andersm/usbcart/usbcart-mfg/readme.txt

Manufacturing documents for USB Flash Cartridge for the Sega Saturn
<http://www.iki.fi/Anders.Montonen/sega/usbcart/>

Released under the terms of the Creative Commons Attribution-ShareAlike 3.0 Unported (CC BY-SA 3.0)
<http://creativecommons.org/licenses/by-sa/3.0/>

The cartridge should be made using 1.6mm thick PCB material. The bottom silkscreen layer contains
the board outline.

The BOM lists example manufacturer part numbers for the logic ICs, but equivalent parts from other
manufacturers can be substituted.
