andersm/usbcart/(threads)

Thread 2 (2017-06-27):

Build and flash

aovrn, 2017-06-27:
Hi!
I tried to build pcb and flash it.
I built romimage.bin with this tool: gnush_v10.03_elf-1-1.i386.rpm (it's right compiler?)
Linker outputs this warning:
 .../4.5-GNUSH_v10.03/../../../../sh-elf/bin/ld: warning: dot moved backwards before `.rodata.align2'
Is it problem or I can ignore it?

And second question how can I flash firmware to chip? Any information about it would be useful for me. I got fail with swap trick, so I need flash firmware before build cart.

Thank you very much!

andersm, 2017-06-27:
It's probably not a problem, but can't say for sure. The toolchains I'm using don't produce any warnings.

If you can't get code running on the Saturn you'll have to use an eprommer to program the chips before soldering them.

aovrn, 2017-06-28:
Thank you for answer!
I need to flash raw romimage.bin or it needs some preparation?

andersm, 2017-06-28:
The compiled image is ready for flashing.

aovsu, 2017-06-30:
Thank you

Closed 2017-07-04.

Thread 3 (2020-04-13):

Can't Open in KiCad 5.1.2

JensRestemeier, 2020-04-13:
I just want to mention that I've got difficulties opening the schematic in KiCad, as it reports missing libraries, and some files are still the old file formats. Is it possible that you've got untracked/unsubmitted files for the KiCad project?

andersm, 2020-04-13:
The cache library was missing from the repository, but has been added. It's is still going to complain about missing libraries, but that's a consequence of KiCad 5 changing how libraries are handled.

Closed 2020-04-13.

Thread 5 (2020-06-07):

Suggestions: Silkscreen + Flash footprints

JensRestemeier, 2020-06-07:
I finally got my cart to work! Awesome project!

Some (low priority) suggestions:
- could you mark the odd and even address flash ROMs on the silkscreen?
- would it be possible to wire the extra address lines on the flash footprints for 39sf040?
- is there enough room for through-hole PLCC sockets for the flash, in addition to the SMD footprints?

andersm, 2020-06-15:
Modifying the silkscreen would be redundant. That information is already provided through the part number and schematic.

The cartridge design is complete, as far as I'm concerned, but feel free to fork and modify it. Though if you do, the layout and routing should be completely redone, it is quite messy.

Closed 2020-06-15.

Thread 6 (2023-10-24):

¿Puedes compartir las herramientas de compilación?

ribenyamazun123, 2023-10-24:
¿Puedes compartir las herramientas de compilación?

andersm, 2023-10-25:
Sorry, I don't speak Spanish.

ribenyamazun123, 2023-10-31:
Can you share the compiler of the arflasher folder?

andersm, 2023-10-31:
No, but you can try creating one with e.g. Crosstool-NG. There's also various binary distributions for different operating systems, e.g. SSSDK maintained by vbt, Jo Engine, etc.

Closed 2023-11-22.
