andersm/usbcart/usbcart-kicad/usbcart.sch

## KiCad design usbcart-kicad/usbcart.sch (2020-04-09)

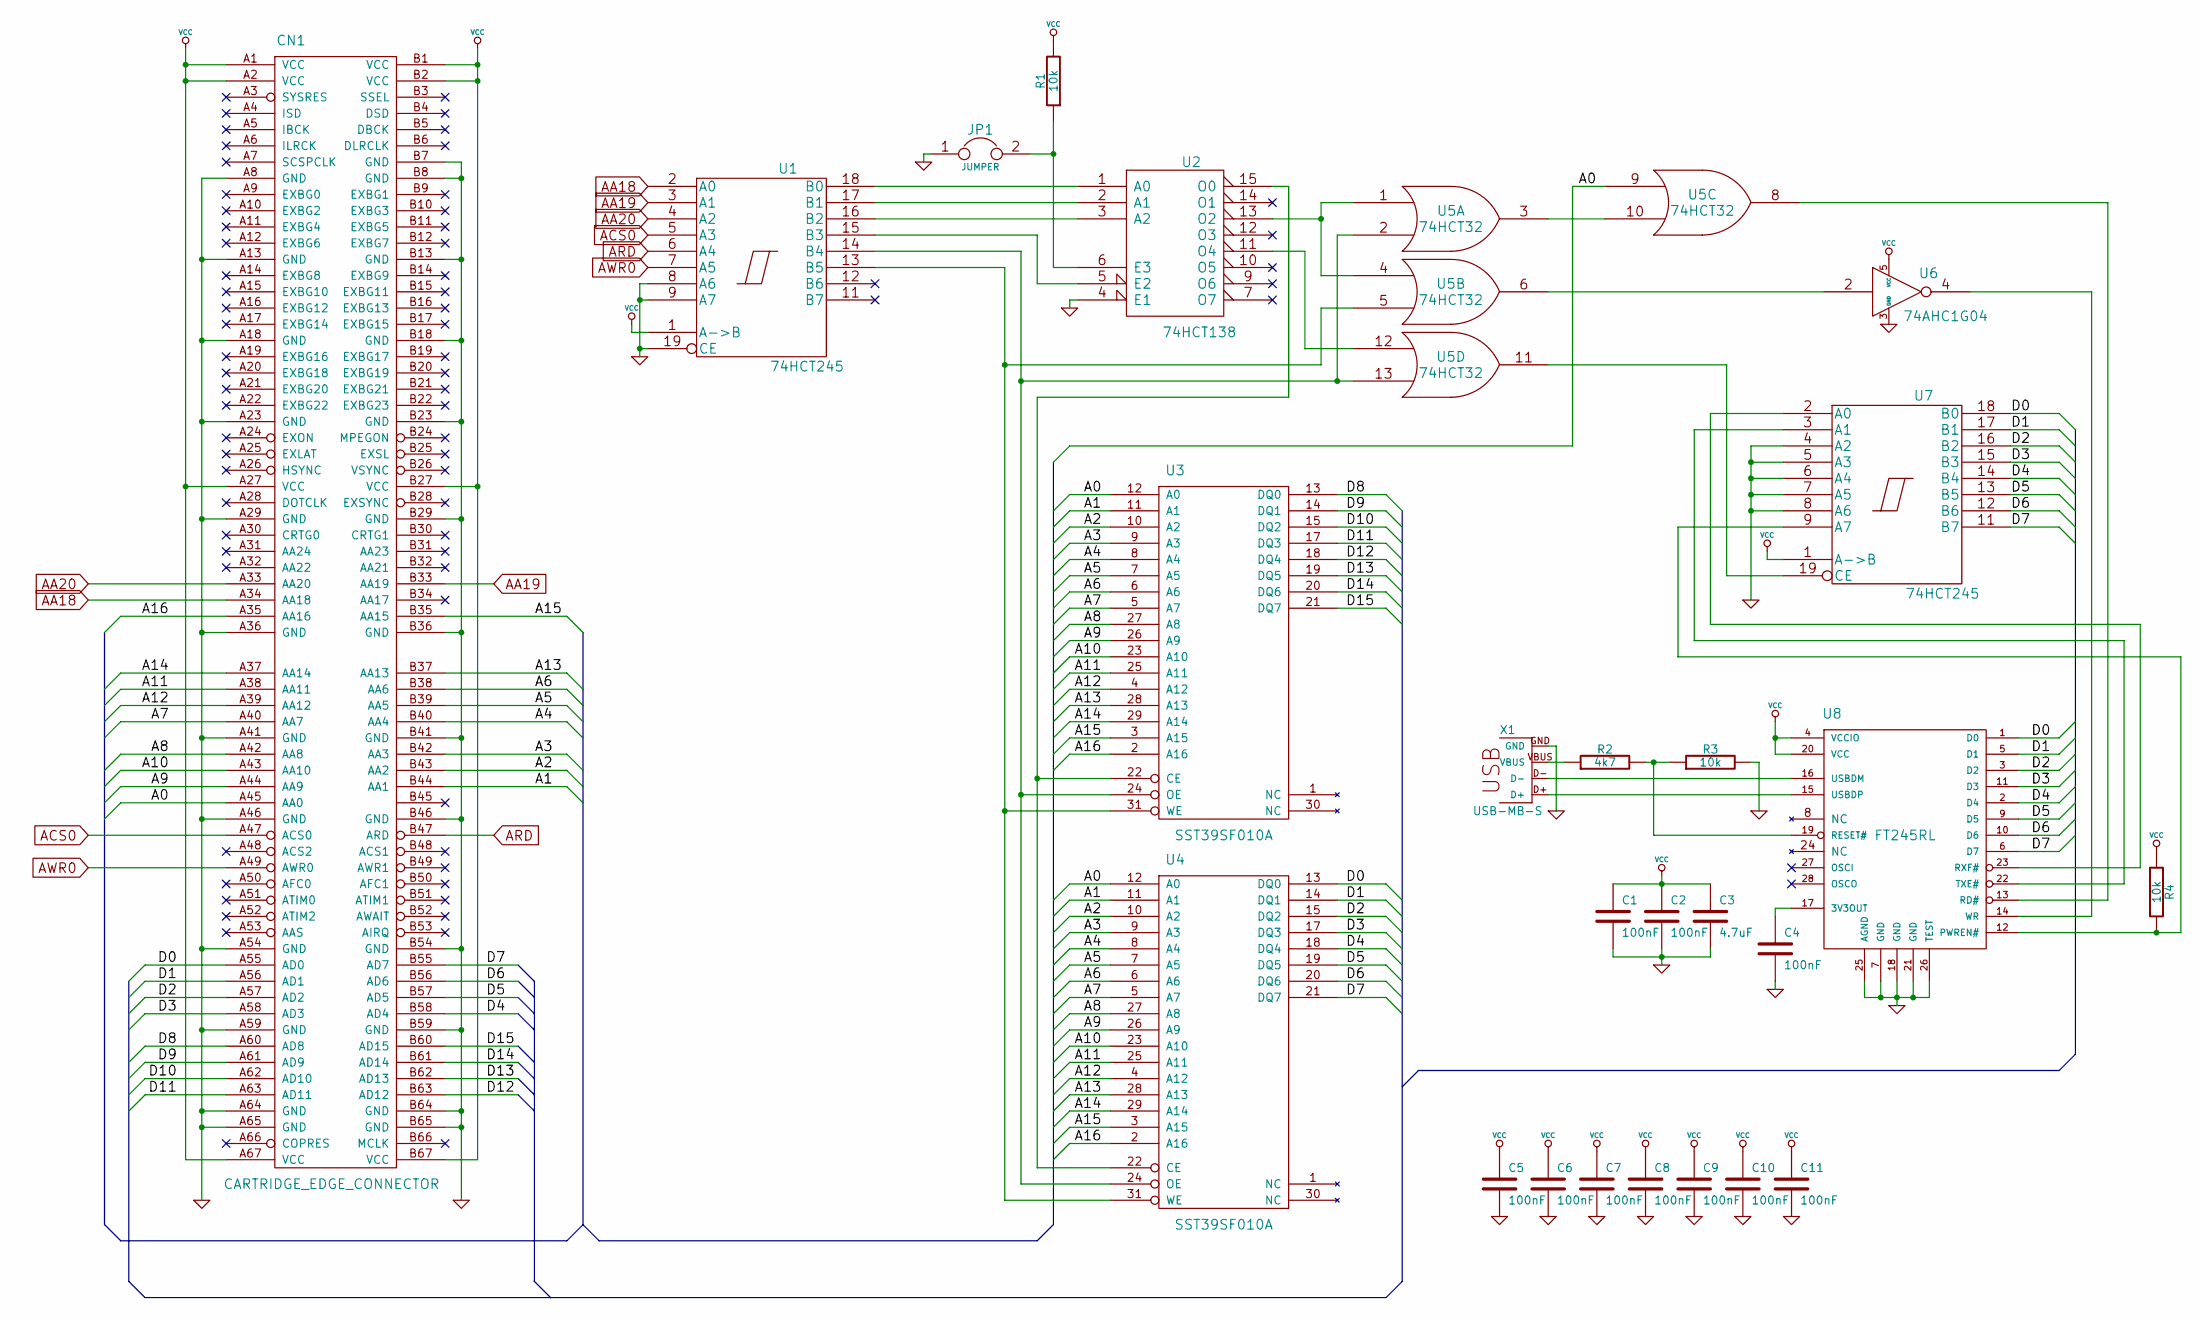
[picture p1: schematic usbcart.sch]

Parts:
C1, C2, C4: 100nF; SM0603
C3: 4.7uF; SM0603
C5, C6, C7, C8, C9, C10, C11: 100nF
CN1: CARTRIDGE_EDGE_CONNECTOR; CARTRIDGE_EDGE_CONNECTOR2
JP1: JUMPER; SIL-2
R1, R3, R4: 10k; SM0603
R2: 4k7; SM0603
U1, U7: 74HCT245; soic-20
U2: 74HCT138; so-16
U3, U4: SST39SF010A; PLCC32
U5: 74HCT32; so-14
U6: 74AHC1G04; SOT23-5
U8: FT245RL; SSOP28
X1: USB-MB-S; con-usb-USB-MB-S

Connections:
A0: CN1.A45 (AA0), U3.12 (A0), U4.12 (A0), U5.9
A1: CN1.B44 (AA1), U3.11 (A1), U4.11 (A1)
A2: CN1.B43 (AA2), U3.10 (A2), U4.10 (A2)
A3: CN1.B42 (AA3), U3.9 (A3), U4.9 (A3)
A4: CN1.B40 (AA4), U3.8 (A4), U4.8 (A4)
A5: CN1.B39 (AA5), U3.7 (A5), U4.7 (A5)
A6: CN1.B38 (AA6), U3.6 (A6), U4.6 (A6)
A7: CN1.A40 (AA7), U3.5 (A7), U4.5 (A7)
A8: CN1.A42 (AA8), U3.27 (A8), U4.27 (A8)
A9: CN1.A44 (AA9), U3.26 (A9), U4.26 (A9)
A10: CN1.A43 (AA10), U3.23 (A10), U4.23 (A10)
A11: CN1.A38 (AA11), U3.25 (A11), U4.25 (A11)
A12: CN1.A39 (AA12), U3.4 (A12), U4.4 (A12)
A13: CN1.B37 (AA13), U3.28 (A13), U4.28 (A13)
A14: CN1.A37 (AA14), U3.29 (A14), U4.29 (A14)
A15: CN1.B35 (AA15), U3.3 (A15), U4.3 (A15)
A16: CN1.A35 (AA16), U3.2 (A16), U4.2 (A16)
AA18: CN1.A34 (AA18), U1.2 (A0)
AA19: CN1.B33 (AA19), U1.3 (A1)
AA20: CN1.A33 (AA20), U1.4 (A2)
ACS0: CN1.A47 (ACS0), U1.5 (A3)
ARD: CN1.B47 (ARD), U1.6 (A4)
AWR0: CN1.A49 (AWR0), U1.7 (A5)
D0: CN1.A55 (AD0), U4.13 (DQ0), U7.18 (B0), U8.1 (D0)
D1: CN1.A56 (AD1), U4.14 (DQ1), U7.17 (B1), U8.5 (D1)
D2: CN1.A57 (AD2), U4.15 (DQ2), U7.16 (B2), U8.3 (D2)
D3: CN1.A58 (AD3), U4.17 (DQ3), U7.15 (B3), U8.11 (D3)
D4: CN1.B58 (AD4), U4.18 (DQ4), U7.14 (B4), U8.2 (D4)
D5: CN1.B57 (AD5), U4.19 (DQ5), U7.13 (B5), U8.9 (D5)
D6: CN1.B56 (AD6), U4.20 (DQ6), U7.12 (B6), U8.10 (D6)
D7: CN1.B55 (AD7), U4.21 (DQ7), U7.11 (B7), U8.6 (D7)
D8: CN1.A60 (AD8), U3.13 (DQ0)
D9: CN1.A61 (AD9), U3.14 (DQ1)
D10: CN1.A62 (AD10), U3.15 (DQ2)
D11: CN1.A63 (AD11), U3.17 (DQ3)
D12: CN1.B63 (AD12), U3.18 (DQ4)
D13: CN1.B62 (AD13), U3.19 (DQ5)
D14: CN1.B61 (AD14), U3.20 (DQ6)
D15: CN1.B60 (AD15), U3.21 (DQ7)
GND: C1.2, C2.2, C3.2, C4.2, C5.2, C6.2, C7.2, C8.2, C9.2, C10.2, C11.2, CN1.A8 (GND), CN1.A13 (GND), CN1.A18 (GND), CN1.A23 (GND), CN1.A29 (GND), CN1.A36 (GND), CN1.A41 (GND), CN1.A46 (GND), CN1.A54 (GND), CN1.A59 (GND), CN1.A64 (GND), CN1.A65 (GND), CN1.B7 (GND), CN1.B8 (GND), CN1.B13 (GND), CN1.B18 (GND), CN1.B23 (GND), CN1.B29 (GND), CN1.B36 (GND), CN1.B41 (GND), CN1.B46 (GND), CN1.B54 (GND), CN1.B59 (GND), CN1.B64 (GND), CN1.B65 (GND), JP1.1, R3.2, U1.8 (A6), U1.9 (A7), U1.19 (CE), U2.4 (E1), U6.3 (GND), U7.4 (A2), U7.5 (A3), U7.6 (A4), U7.7 (A5), U7.8 (A6), U8.7 (GND), U8.18 (GND), U8.21 (GND), U8.25 (AGND), U8.26 (TEST), X1.GND
unnamed: C4.1, U8.17 (3V3OUT)
unnamed: JP1.2, R1.1, U2.6 (E3)
unnamed: R2.1, X1.VBUS
unnamed: R2.2, R3.1, U8.19 (RESET#)
unnamed: R4.2, U7.9 (A7), U8.12 (PWREN#)
unnamed: U1.13 (B5), U3.31 (WE), U4.31 (WE), U5.5
unnamed: U1.14 (B4), U3.24 (OE), U4.24 (OE), U5.2, U5.13
unnamed: U1.15 (B3), U2.5 (E2)
unnamed: U1.16 (B2), U2.3 (A2)
unnamed: U1.17 (B1), U2.2 (A1)
unnamed: U1.18 (B0), U2.1 (A0)
unnamed: U2.11 (O4), U5.12
unnamed: U2.13 (O2), U5.1, U5.4
unnamed: U2.15 (O0), U3.22 (CE), U4.22 (CE)
unnamed: U5.6, U6.2
unnamed: U5.8, U8.13 (RD#)
unnamed: U5.3, U5.10
unnamed: U5.11, U7.19 (CE)
unnamed: U6.4, U8.14 (WR)
unnamed: U7.2 (A0), U8.23 (RXF#)
unnamed: U7.3 (A1), U8.22 (TXE#)
unnamed: U8.15 (USBDP), X1.D+
unnamed: U8.16 (USBDM), X1.D-
VCC: C1.1, C2.1, C3.1, C5.1, C6.1, C7.1, C8.1, C9.1, C10.1, C11.1, CN1.A1 (VCC), CN1.A2 (VCC), CN1.A27 (VCC), CN1.A67 (VCC), CN1.B1 (VCC), CN1.B2 (VCC), CN1.B27 (VCC), CN1.B67 (VCC), R1.2, R4.1, U1.1 (A->B), U6.5 (VCC), U7.1 (A->B), U8.4 (VCCIO), U8.20 (VCC)
