andersm/usbcart/cartrom/main.c

/*

    Sega Saturn USB flash cart ROM
    Copyright © 2012, 2015 Anders Montonen
    All rights reserved.

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
*/

#include <stdint.h>

#include "cpu.h"
#include "scu.h"
#include "vdp2.h"

#include "crc.h"

#define USB_FLAGS (*(volatile uint8_t*)(0x22200001))
#define USB_RXF     (1 << 0)
#define USB_TXE     (1 << 1)
#define USB_PWREN   (1 << 7)
#define USB_FIFO (*(volatile uint8_t*)(0x22100001))

#define WAIT_FOR_READ_FIFO()    do{while((USB_FLAGS&USB_RXF));}while(0)
#define WAIT_FOR_WRITE_FIFO()   do{while((USB_FLAGS&USB_TXE));}while(0)

#define USB_OUT_EP_SIZE 64

#define RGB(r, g, b) ((((b)&0x1f)<<10)|(((g)&0x1f)<<5)|((r)&0x1f))

const uint16_t ColorTable[] =
{
    RGB(   0,    0, 0), /* black  */
    RGB(0x1f,    0, 0), /* red    */
    RGB(   0, 0x1f, 0), /* green  */
    RGB(0x1f, 0x13, 0)  /* orange */
};

typedef enum
{
    BLACK,
    RED,
    GREEN,
    ORANGE
} Color_e;

__attribute__((section(".uncached"), noinline))
static void PurgeCache(void)
{
    uint8_t reg = CCR;
    reg &= ~CCR_CE;
    CCR = reg;
    reg |= CCR_CP;
    CCR = reg;
    reg |= CCR_CE;
    CCR = reg;
}

static void InitDma(void)
{
    (void)CHCR0;
    CHCR0 = 0;
    SAR0 = (uint32_t)&USB_FIFO;
    (void)DMAOR;
    DMAOR = DMAOR_DME;
}

static void ResetDma(void)
{
    (void)CHCR0;
    CHCR0 = 0;
    (void)DMAOR;
    DMAOR = 0;
}

static void ReceiveDma(uint8_t *pBuffer, uint32_t len)
{
    (void)CHCR0;
    CHCR0 = 0;
    DAR0 = (uint32_t)pBuffer;
    TCR0 = len;
    WAIT_FOR_READ_FIFO();
    CHCR0 = CHCR_DM0|CHCR_AR|CHCR_DE;
    while ((CHCR0 & CHCR_TE) == 0) ;
}

static void SetScreenColor(Color_e color)
{
    *(uint16_t*)VDP2_VRAM = ColorTable[color];
}

static void SignalError(void)
{
    /* Display a red screen for two seconds. */
    int delay = 60*2; /* Doesn't take 50Hz display into account.. */

    SetScreenColor(RED);
    while(delay > 0)
    {
        WaitForVBLANKIn();
        WaitForVBLANKOut();
        --delay;
    }
}

static uint8_t RecvByte(void)
{
    WAIT_FOR_READ_FIFO();
    return USB_FIFO;
}

static uint32_t RecvDword(void)
{
    uint32_t tmp = RecvByte();
    tmp = (tmp << 8) | RecvByte();
    tmp = (tmp << 8) | RecvByte();
    tmp = (tmp << 8) | RecvByte();

    return tmp;
}

static void SendByte(uint8_t byte)
{
    WAIT_FOR_WRITE_FIFO();
    USB_FIFO = byte;
}

static void DoDownload(void)
{
    uint8_t    *pData;
    uint32_t    len;
    crc_t       checksum = crc_init();

    SetScreenColor(ORANGE);

    pData = (uint8_t*)RecvDword();
    len = RecvDword();

    for (uint32_t ii = 0; ii < len; ++ii)
    {
        WAIT_FOR_WRITE_FIFO();
        USB_FIFO = pData[ii];
    }

    checksum = crc_update(checksum, pData, len);
    checksum = crc_finalize(checksum);

    SendByte(checksum);
}

static void DoDmaUpload(uint8_t *pBuffer, uint32_t len)
{
    while (len > 0)
    {
        uint32_t l = (len < USB_OUT_EP_SIZE ? len : USB_OUT_EP_SIZE);
        ReceiveDma(pBuffer, l);
        pBuffer += l;
        len -= l;
    }
}

static void DoUpload(void)
{
    uint8_t    *pData;
    uint32_t    len;
    crc_t       readchecksum;
    crc_t       checksum = crc_init();

    SetScreenColor(ORANGE);

    pData = (uint8_t*)RecvDword();
    len = RecvDword();

    DoDmaUpload(pData, len);

    readchecksum = RecvByte();

    PurgeCache();
    checksum = crc_update(checksum, pData, len);
    checksum = crc_finalize(checksum);

    if (checksum != readchecksum)
    {
        SendByte(0x1);
        SignalError();
    }
    else
    {
        SendByte(0);
    }
}

static void DoExecute(void)
{
    /* Read address, execute call. */
    void (*pFun)(void);

    pFun = (void(*)(void))RecvDword();
    (*pFun)();
}

/* Setup back screen and color entries, turns video on. */
static void InitVideo(void)
{
    TVMD = 0x8110;
    BGON  = 0;
    LCTAU = 0;
    LCTAL = 0;
    BKTAL = 0;
    BKTAU = 0;
    SetScreenColor(BLACK);
}

int main(void)
{
    uint8_t command;

    InitVideo();

    while(1)
    {
        SetScreenColor(GREEN);
        command = RecvByte();
        switch (command)
        {
        case 1:
            DoDownload();
            break;
        case 2:
            InitDma();
            DoUpload();
            ResetDma();
            break;
        case 3:
            DoExecute();
            InitVideo();
            break;
        }
    }

    return 0;
}
