andersm/usbcart/arflasher/conio.c

/*

    Sega Saturn cartridge flash tool
    Copyright © 2012, 2015 Anders Montonen
    Original software by ExCyber
    Graphics routines by Charles MacDonald
    All rights reserved.

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
*/

#include <stdint.h>

#include "vdp2.h"

static const char hextable[16] = {"0123456789ABCDEF"};

static const uint16_t vga_pal[256] = {
    0x0000, 0x5400, 0x02A0, 0x56A0, 0x0015, 0x5415, 0x0155, 0x56B5, 0x294A, 0x7D4A, 0x2BEA, 0x7FEA, 0x295F, 0x7D5F, 0x2BFF, 0x7FFF,
    0x0000, 0x0842, 0x1084, 0x14A5, 0x1CE7, 0x2108, 0x294A, 0x318C, 0x39CE, 0x4210, 0x4A52, 0x5294, 0x5AD6, 0x6739, 0x739C, 0x7FFF,
    0x7C00, 0x7C08, 0x7C0F, 0x7C17, 0x7C1F, 0x5C1F, 0x3C1F, 0x201F, 0x001F, 0x011F, 0x01FF, 0x02FF, 0x03FF, 0x03F7, 0x03EF, 0x03E8,
    0x03E0, 0x23E0, 0x3FE0, 0x5FE0, 0x7FE0, 0x7EE0, 0x7DE0, 0x7D00, 0x7DEF, 0x7DF3, 0x7DF7, 0x7DFB, 0x7DFF, 0x6DFF, 0x5DFF, 0x4DFF,
    0x3DFF, 0x3E7F, 0x3EFF, 0x3F7F, 0x3FFF, 0x3FFB, 0x3FF7, 0x3FF3, 0x3FEF, 0x4FEF, 0x5FEF, 0x6FEF, 0x7FEF, 0x7F6F, 0x7EEF, 0x7E6F,
    0x7ED6, 0x7ED8, 0x7EDB, 0x7EDD, 0x7EDF, 0x76DF, 0x6EDF, 0x62DF, 0x5ADF, 0x5B1F, 0x5B7F, 0x5BBF, 0x5BFF, 0x5BFD, 0x5BFB, 0x5BF8,
    0x5BF6, 0x63F6, 0x6FF6, 0x77F6, 0x7FF6, 0x7FB6, 0x7F76, 0x7F16, 0x3800, 0x3803, 0x3807, 0x380A, 0x380E, 0x280E, 0x1C0E, 0x0C0E,
    0x000E, 0x006E, 0x00EE, 0x014E, 0x01CE, 0x01CA, 0x01C7, 0x01C3, 0x01C0, 0x0DC0, 0x1DC0, 0x29C0, 0x39C0, 0x3940, 0x38E0, 0x3860,
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
     0x38, 0x60, 0xC0, 0xF8, 0xCC, 0xCC, 0x78, 0x00, 0xFC, 0xCC, 0x0C, 0x18, 0x30, 0x30, 0x30, 0x00,
     0x78, 0xCC, 0xCC, 0x78, 0xCC, 0xCC, 0x78, 0x00, 0x78, 0xCC, 0xCC, 0x7C, 0x0C, 0x18, 0x70, 0x00,
     0x00, 0x30, 0x30, 0x00, 0x00, 0x30, 0x30, 0x00, 0x00, 0x30, 0x30, 0x00, 0x00, 0x30, 0x30, 0x60,
     0x18, 0x30, 0x60, 0xC0, 0x60, 0x30, 0x18, 0x00, 0x00, 0x00, 0xFC, 0x00, 0x00, 0xFC, 0x00, 0x00,
     0x60, 0x30, 0x18, 0x0C, 0x18, 0x30, 0x60, 0x00, 0x78, 0xCC, 0x0C, 0x18, 0x30, 0x00, 0x30, 0x00,
     0x7C, 0xC6, 0xDE, 0xDE, 0xDE, 0xC0, 0x78, 0x00, 0x30, 0x78, 0xCC, 0xCC, 0xFC, 0xCC, 0xCC, 0x00,
     0xFC, 0x66, 0x66, 0x7C, 0x66, 0x66, 0xFC, 0x00, 0x3C, 0x66, 0xC0, 0xC0, 0xC0, 0x66, 0x3C, 0x00,
     0xF8, 0x6C, 0x66, 0x66, 0x66, 0x6C, 0xF8, 0x00, 0x7E, 0x60, 0x60, 0x78, 0x60, 0x60, 0x7E, 0x00,
     0x7E, 0x60, 0x60, 0x78, 0x60, 0x60, 0x60, 0x00, 0x3C, 0x66, 0xC0, 0xC0, 0xCE, 0x66, 0x3E, 0x00,
     0xCC, 0xCC, 0xCC, 0xFC, 0xCC, 0xCC, 0xCC, 0x00, 0x78, 0x30, 0x30, 0x30, 0x30, 0x30, 0x78, 0x00,
     0x1E, 0x0C, 0x0C, 0x0C, 0xCC, 0xCC, 0x78, 0x00, 0xE6, 0x66, 0x6C, 0x78, 0x6C, 0x66, 0xE6, 0x00,
     0x60, 0x60, 0x60, 0x60, 0x60, 0x60, 0x7E, 0x00, 0xC6, 0xEE, 0xFE, 0xFE, 0xD6, 0xC6, 0xC6, 0x00,
     0xC6, 0xE6, 0xF6, 0xDE, 0xCE, 0xC6, 0xC6, 0x00, 0x38, 0x6C, 0xC6, 0xC6, 0xC6, 0x6C, 0x38, 0x00,
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
};

void conio_init(void)
{
    int ii;
    volatile uint16_t *vdp2_cram = (volatile uint16_t*)VDP2_CRAM;
    for (ii = 0; ii < 256; ii++)
        vdp2_cram[ii] = vga_pal[ii];

    vdp2_cram[0] = vdp2_cram[1];
    vdp2_cram[1] = 0x10 << 10;
}

void _printchar(int x, int y, uint8_t color, char v)
{
    int r, c;
    volatile uint8_t *bmp = (volatile uint8_t*)VDP2_VRAM;
    uint8_t fg = (color >> 4) & 0x0F;
    uint8_t bg = (color >> 0) & 0x0F;

    for (r = 0; r < 8; r++)
    {
        uint8_t b = font[v<<3|r];
        for (c = 0; c < 8; c++)
        {
            uint8_t d = (b & (0x80 >> c)) ? fg : bg;
            bmp[((y<<3|r)<<10)+(x<<3|c)] = d;
        }
    }
}

void _printf(int x, int y, uint8_t color, const char *s)
{
    int ii;
    for (ii = 0; s[ii] != 0; ii++)
        _printchar(x+ii, y, color, s[ii]);
}

void _printhexd(int x, int y, uint8_t color, uint8_t v)
{
    _printchar(x, y, color, hextable[v&0x0F]);
}

void _printhexb(int x, int y, uint8_t color, uint8_t v)
{
    _printchar(x+0, y, color, hextable[(v>>4)&0x0F]);
    _printchar(x+1, y, color, hextable[v & 0x0F]);
}

void _printhexw(int x, int y, uint8_t color, uint16_t v)
{
    _printchar(x+0, y, color, hextable[(v>>12)&0x0F]);
    _printchar(x+1, y, color, hextable[(v>>8)&0x0F]);
    _printchar(x+2, y, color, hextable[(v>>4)&0x0F]);
    _printchar(x+3, y, color, hextable[v & 0x0F]);
}

void _printhexl(int x, int y, uint8_t color,uint32_t v)
{
    _printchar(x+0, y, color, hextable[(v>>28)&0x0F]);
    _printchar(x+1, y, color, hextable[(v>>24)&0x0F]);
    _printchar(x+2, y, color, hextable[(v>>20)&0x0F]);
    _printchar(x+3, y, color, hextable[(v>>16)&0x0F]);
    _printchar(x+4, y, color, hextable[(v>>12)&0x0F]);
    _printchar(x+5, y, color, hextable[(v>>8)&0x0F]);
    _printchar(x+6, y, color, hextable[(v>>4)&0x0F]);
    _printchar(x+7, y, color, hextable[v & 0x0F]);
}
