andersm/usbcart/(commit log)

2013-02-14 Import files.
    [usbcart.brd, usbcart.sch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]
2015-05-20 Use DMA when transferring data from the host to the Saturn.
2015-05-24 Revert earlier change. This form is more readable.
    [main.c]
2016-07-01 Refactor DMA transfer code
    Simplify the inner loop, allowing all the code to be inlined.
2019-07-03 Add explanation of the DMA transfer logic
2020-04-09 Fix schematic importing into KiCad 5.1
    [usbcart.sch]
2020-04-09 Remove executable bits from files
    [usbcart.brd, usbcart.sch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]
2020-04-13 Add missing KiCad cache library
2020-04-13 Don't ignore KiCad cache libraries
