andersm/usbcart/(notices)

Notices in the files:
usbcart-kicad/usbcart.sch:
Distributed under the CC-BY-SA license
